BRichter99/Xbox360-Controller-with-BLE/BleConnectionStatus.h

#ifndef ESP32_BLE_CONNECTION_STATUS_H
#define ESP32_BLE_CONNECTION_STATUS_H
#include "sdkconfig.h"
#if defined(CONFIG_BT_ENABLED)

#include <BLEServer.h>
#include "BLE2902.h"
#include "BLECharacteristic.h"

class BleConnectionStatus : public BLEServerCallbacks
{
private:
  BLE2902* descriptor();
public:
  BleConnectionStatus(void);
  SemaphoreHandle_t sem;
  bool connected = false;
  void onConnect(BLEServer* pServer);
  void onDisconnect(BLEServer* pServer);
  BLECharacteristic* inputGamepad;
};

#endif // CONFIG_BT_ENABLED
#endif // ESP32_BLE_CONNECTION_STATUS_H
