BRichter99/Xbox360-Controller-with-BLE/(commit log)

2020-11-09 Change pins: avoid ADC2 since it's unavailable when Bluetooth is enabled
    [GamepadPins.h]
2020-11-18 Add infrastructure for multiple input-profiles: * add class Profiles, which handles all inputs * add LedModule * some simplicity in loop()
2020-12-25 Improve multitasking blocking behavior + Switch button
